anilgarg/Audio-Transmission-and-Reception-over-RF/Transmitter/SourceCode/rfEasyLinkTx_8KSPS_Final_V0/README.md

# rfEasyLinkTx
---

### SysConfig Notice

All examples will soon be supported by SysConfig, a tool that will help you 
graphically configure your software components. A preview is available today in 
the examples/syscfg_preview directory. Starting in 3Q 2019, with SDK version 
3.30, only SysConfig-enabled versions of examples will be provided. For more 
information, click [here](http://www.ti.com/sysconfignotice).

-------------------------

Project Setup using the System Configuration Tool (SysConfig)
-------------------------
The purpose of SysConfig is to provide an easy to use interface for configuring 
drivers, RF stacks, and more. The .syscfg file provided with each example 
project has been configured and tested for that project. Changes to the .syscfg 
file may alter the behavior of the example away from default. Some parameters 
configured in SysConfig may require the use of specific APIs or additional 
modifications in the application source code. More information can be found in 
SysConfig by hovering over a configurable and clicking the question mark (?) 
next to it's name.

### EasyLink Stack Configuration
Many parameters of the EasyLink stack can be configured using SysConfig 
including RX, TX, Radio, and Advanced settings. More information can be found in 
SysConfig by hovering over a configurable and clicking the question mark (?) 
next to it's name. Alternatively, refer to the System Configuration Tool 
(SysConfig) section of the Proprietary RF User's guide found in 
&lt;SDK_INSTALL_DIR&gt;/docs/proprietary-rf/proprietary-rf-users-guide.html. 

Example Summary
---------------
Example includes the EasyLink API and uses it to configure the RF driver to
transmit packets. This project should be run in conjunction with the
rfEasyLinkRx project.

For more information on the EasyLink API and usage refer to the [Proprietary RF User's guide](http://dev.ti.com/tirex/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's%20Guide)

Peripherals Exercised
---------------------
* `Board_PIN_LED1` - Indicates that a packet has been transmitted
* `Board_PIN_LED2` - Indicates an abort which is expected after transmitting 10 packets
 `Board_PIN_LED1` & `Board_PIN_LED2` indicate an error

Resources & Jumper Settings
---------------------------
> If you're using an IDE (such as CCS or IAR), please refer to Board.html in your project
directory for resources used and board-specific jumper settings. Otherwise, you can find
Board.html in the directory &lt;SDK_INSTALL_DIR&gt;/source/ti/boards/&lt;BOARD&gt;.

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

Example Usage
-------------
Run the example. Board_PIN_LED1 will toggle every 100 ms indicating a packet has
been transmitted. This will happen 10 times. The 11th transmission will then be
aborted, toggling Board_PIN_LED2. This cycle will continue.

Before running this application you should first start the rfEasyLinkRx on a
second board to see that the transmitted packets are received.

On the CC1352P-4, if the High PA is enabled, i.e. high output power, the user
may choose to set the output power, using the *EasyLink_setRfPower()*, to 20 dBm
instead of the default 12 dBm.

Application Design Details
--------------------------
This example shows how to use the EasyLink API to access the RF driver, set the
frequency and transmit packets. The RFEASYLINKTX_ASYNC define is used to select
between the Blocking or Async TX API.

The rfEasyLinkTx example will transmit a packet every 10 ms for 10 packets, if
RFEASYLINKTX_ASYNC is defined (as it is by default) then the 11th TX will be
scheduled, but will be aborted. This is to show an example of aborting a TX.
LED2 will toggle when a TX abort happens. Board_PIN_LED1 and Board_PIN_LED2 indicates an
error (not expected to happen). The TX/abort cycle will repeat indefinitely.

A single task, "rfEasyLinkTxFnx", configures the RF driver through the EasyLink
API and transmits messages.

EasyLink API
-------------------------
### Overview
The EasyLink API should be used in application code. The EasyLink API is
intended to abstract the RF Driver in order to give a simple API for
customers to use as is or extend to suit their application[Use Cases]
(@ref USE_CASES).

### General Behavior
Before using the EasyLink API:

  - The EasyLink Layer is initialized by calling EasyLink_init(). This
    initializes and opens the RF driver and configures a modulation scheme
    passed to EasyLink_init.
  - The RX and TX can operate independently of each other.

The following is true for receive operation:

  - RX is enabled by calling EasyLink_receive() or EasyLink_receiveAsync()
  - Entering RX can be immediate or scheduled
  - EasyLink_receive() is blocking and EasyLink_receiveAsync() is non-blocking
  - The EasyLink API does not queue messages so calling another API function
    while in EasyLink_receiveAsync() will return EasyLink_Status_Busy_Error
  - An Async operation can be canceled with EasyLink_abort()

The following apply for transmit operation:

  - TX is enabled by calling EasyLink_transmit(), EasyLink_transmitAsync()
    or EasyLink_transmitCcaAsync()
  - TX can be immediate or scheduled
  - EasyLink_transmit() is blocking and EasyLink_transmitAsync(),
    EasyLink_transmitCcaAsync() are non-blocking
  - EasyLink_transmit() for a scheduled command, or if TX cannot start
  - The EasyLink API does not queue messages so calling another API function
    while in either EasyLink_transmitAsync() or EasyLink_transmitCcaAsync()
    will return EasyLink_Status_Busy_Error
  - An Async operation can be canceled with EasyLink_abort()

### Error Handling
The EasyLink API will return EasyLink_Status containing success or error
  code. The EasyLink_Status codes are:

   - EasyLink_Status_Success
   - EasyLink_Status_Config_Error
   - EasyLink_Status_Param_Error
   - EasyLink_Status_Mem_Error
   - EasyLink_Status_Cmd_Error
   - EasyLink_Status_Tx_Error
   - EasyLink_Status_Rx_Error
   - EasyLink_Status_Rx_Timeout
   - EasyLink_Status_Busy_Error
   - EasyLink_Status_Aborted

### Power Management
The power management framework will try to put the device into the most
power efficient mode whenever possible. Please see the technical reference
manual for further details on each power mode.

The EasyLink Layer uses the power management offered by the RF driver Refer to the RF
Driver documentation for more details.

# No-RTOS Implementation #
The No-RTOS implementation uses *usleep()* to implement the timeout
feature for the asynchronous case.

### Supported Functions
    | Generic API function          | Description                                        |
    |-------------------------------|----------------------------------------------------|
    | EasyLink_init()               | Init's and opens the RF driver and configures the  |
    |                               | specified settings based on EasyLink_Params struct |
    | EasyLink_transmit()           | Blocking Transmit                                  |
    | EasyLink_transmitAsync()      | Non-blocking Transmit                              |
    | EasyLink_transmitCcaAsync()   | Non-blocking Transmit with Clear Channel Assessment|
    | EasyLink_receive()            | Blocking Receive                                   |
    | EasyLink_receiveAsync()       | Non-blocking Receive                                |
    | EasyLink_abort()              | Aborts a non blocking call                         |
    | EasyLink_enableRxAddrFilter() | Enables/Disables RX filtering on the Addr          |
    | EasyLink_getIeeeAddr()        | Gets the IEEE Address                              |
    | EasyLink_setFrequency()       | Sets the frequency                                 |
    | EasyLink_getFrequency()       | Gets the frequency                                 |
    | EasyLink_setRfPower()         | Sets the Tx Power                                  |
    | EasyLink_getRfPower()         | Gets the Tx Power                                  |
    | EasyLink_getRssi()            | Gets the RSSI                                      |
    | EasyLink_getAbsTime()         | Gets the absolute time in RAT ticks                |
    | EasyLink_setCtrl()            | Set RF parameters, test modes or EasyLink options  |
    | EasyLink_getCtrl()            | Get RF parameters or EasyLink options              |
    | EasyLink_getIeeeAddr()        | Gets the IEEE address                              |

### Frame Structure
The EasyLink implements a basic header for transmitting and receiving data. This header supports
addressing for a star or point-to-point network with acknowledgments.

Packet structure:

     _________________________________________________________
    |           |                   |                         |
    | 1B Length | 1-64b Dst Address |         Payload         |
    |___________|___________________|_________________________|

Note for IAR users: When using the CC1310DK, the TI XDS110v3 USB Emulator must
be selected. For the CC1310_LAUNCHXL, select TI XDS110 Emulator. In both cases,
select the cJTAG interface.
