anilgarg/Audio-Transmission-and-Reception-over-RF/Report/backup.pptx

## Adaptive differential pulse code modulation (ADPCM compression technique)

Decoder

Si

+

Mixer

d

Inverse quantization

dq

Mixer

Sp

Quantizer

+

+

Sr

Sp

q

Step size predictor

Adaptive predictor


Encoded code

Sound wave source: [online]http://www.sampleswap.org downloaded:15/10/19

## RF core command handling

RF operation state chart

SDL diagram of the evaluating phase

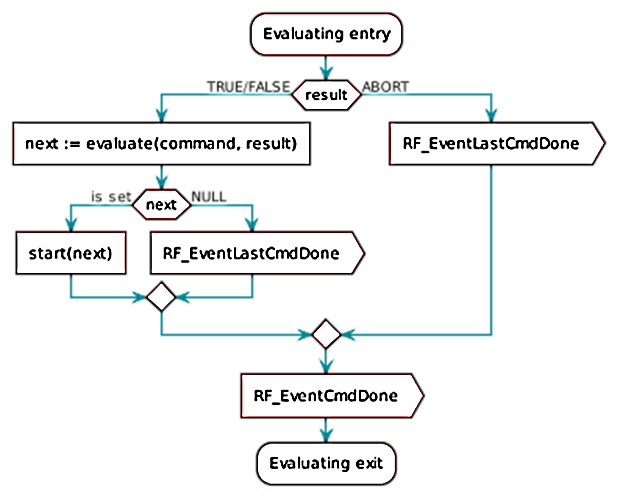
[picture p2: figure]
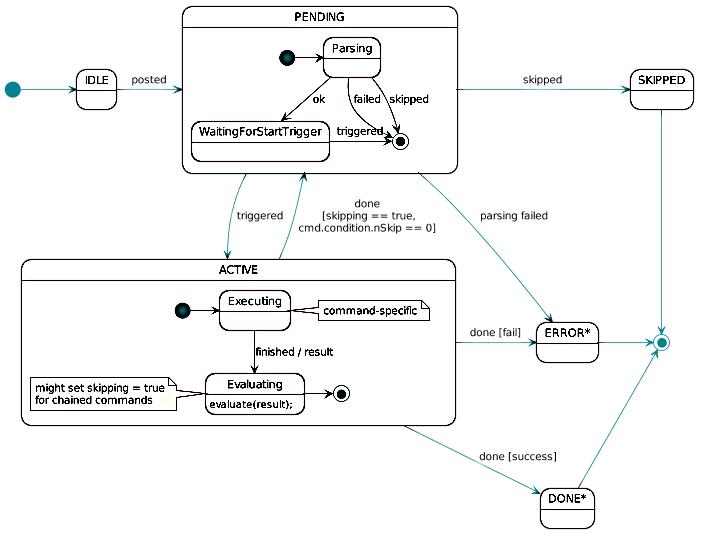
[picture p3: figure]
@startuml scale 0.8 state PENDING { state Parsing state WaitingForStartTrigger [*] -> Parsing Parsing --> WaitingForStartTrigger : ok Parsing --> [*] : failed Parsing --> [*] : skipped WaitingForStartTrigger -> [*] : triggered } state ACTIVE { state Executing note right command-specific end note s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

* Image Source: (https://www.google.co.in/url?cd=&psig=AOvVaw2xpKLntZdZuiC2camuncHq)http://dev.ti.com/tirex/content/simplelink_cc13x0_sdk_1_30_00_06/docs/

## RF core command handling

Callback events for two chained RF operations op1 and op2

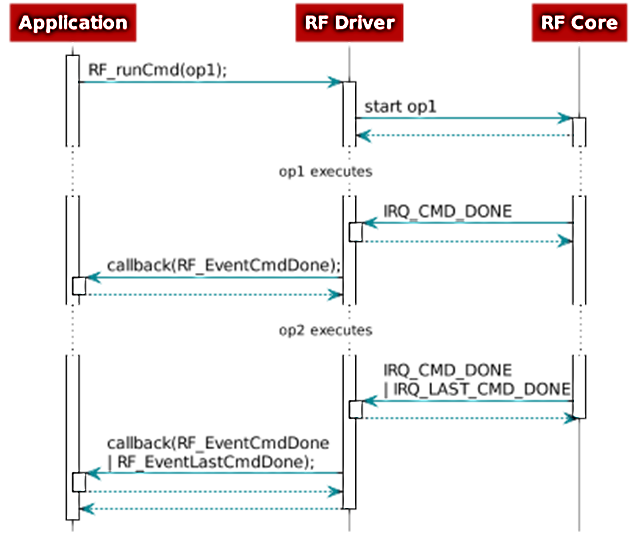
[picture p4: figure]

* Image Source: (https://www.google.co.in/url?cd=&psig=AOvVaw2xpKLntZdZuiC2camuncHq)http://dev.ti.com/tirex/content/simplelink_cc13x0_sdk_1_30_00_06/docs/

Callback events for CMD_PROP_RX

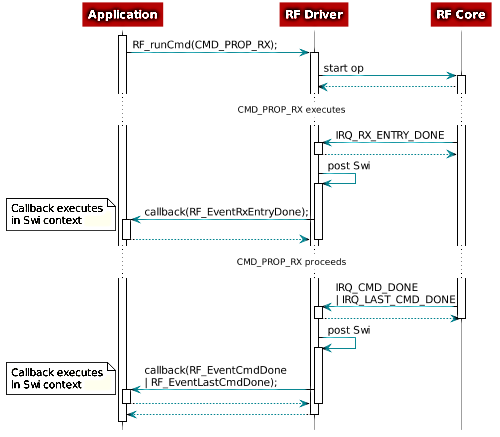
[picture p5: figure]
@startuml scale 0.8 hide footbox participant Application as app participant "RF Driver" as driver participant "RF Core" as rf activate app app -> driver : RF_runCmd(CMD_PROP_RX); activate driver driver -> rf : start op activate rf driver <-- rf ...CMD_PROP_RX executes... driver <- rf : IRQ_RX_ENTR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

## EasyLink API reference

- Data Sending
  - EasyLink layer is initialized by calling EasyLink_init (http://dev.ti.com/tirex/content/simplelink_cc13x0_sdk_2_20_00_38/docs/proprietary-rf/proprietary-rf-users-guide/easylink/easylink-api-reference.html)() (http://dev.ti.com/tirex/content/simplelink_cc13x0_sdk_2_20_00_38/docs/proprietary-rf/proprietary-rf-users-guide/easylink/easylink-api-reference.html).
  - TX is enabled by calling EasyLink_transmitAsync (http://dev.ti.com/tirex/content/simplelink_cc13x0_sdk_2_20_00_38/docs/proprietary-rf/proprietary-rf-users-guide/easylink/easylink-api-reference.html)() (http://dev.ti.com/tirex/content/simplelink_cc13x0_sdk_2_20_00_38/docs/proprietary-rf/proprietary-rf-users-guide/easylink/easylink-api-reference.html)
  - Entering TX can be immediate or scheduled.
  - an Async operation can be cancelled with EasyLink_abort (http://dev.ti.com/tirex/content/simplelink_cc13x0_sdk_2_20_00_38/docs/proprietary-rf/proprietary-rf-users-guide/easylink/easylink-api-reference.html)() (http://dev.ti.com/tirex/content/simplelink_cc13x0_sdk_2_20_00_38/docs/proprietary-rf/proprietary-rf-users-guide/easylink/easylink-api-reference.html)

* Image Source: (https://www.google.co.in/url?cd=&psig=AOvVaw2xpKLntZdZuiC2camuncHq)http://dev.ti.com/tirex/content/simplelink_cc13x0_sdk_1_30_00_06/docs/

Packet Format

- Data Receiving
  - EasyLink layer is initialized by calling EasyLink_init (http://dev.ti.com/tirex/content/simplelink_cc13x0_sdk_2_20_00_38/docs/proprietary-rf/proprietary-rf-users-guide/easylink/easylink-api-reference.html)() (http://dev.ti.com/tirex/content/simplelink_cc13x0_sdk_2_20_00_38/docs/proprietary-rf/proprietary-rf-users-guide/easylink/easylink-api-reference.html).
  - RX is enabled by calling EasyLink_receiveAsync (http://dev.ti.com/tirex/content/simplelink_cc13x0_sdk_2_20_00_38/docs/proprietary-rf/proprietary-rf-users-guide/easylink/easylink-api-reference.html)() (http://dev.ti.com/tirex/content/simplelink_cc13x0_sdk_2_20_00_38/docs/proprietary-rf/proprietary-rf-users-guide/easylink/easylink-api-reference.html).
  - Entering RX can be immediate or scheduled.
  - an Async operation can be cancelled with EasyLink_abort (http://dev.ti.com/tirex/content/simplelink_cc13x0_sdk_2_20_00_38/docs/proprietary-rf/proprietary-rf-users-guide/easylink/easylink-api-reference.html)() (http://dev.ti.com/tirex/content/simplelink_cc13x0_sdk_2_20_00_38/docs/proprietary-rf/proprietary-rf-users-guide/easylink/easylink-api-reference.html)

## Slide 5

Software architecture

Main CPU

1. Main Application
2. Non-RTOS
3. Drivers
4. IDE- Code composer studio

RF core
ARM
Cortex-M0

Sensor controller

Peripherals

Main CPU
ARM
Cortex-M3

RF core

1. Extremely flexible ultra- low power radio
2. Built in autonomous packet engine
3. IDE: Smart RF studio

Sensor controller

1. Ultra low power sensor interface
2. ADC Interface ( 4ksps)

Peripherals

1. GPIO
2. DMA
3. Timer
4. SPI ( DAC Interface)

Software

TI Simple Link PHY
1. 802.15.4g FSK
2. Proprietary
3. Long Range Communication

Power consumption
Main MCU (Active@48Mhz) | 1.2mA + 25.5μA/Hz
Radio Rx | 5.5mA
RF core | 0.237mA
μDMA | 0.130mA
Timer | 0.113mA
I2C | 0.012mA
SPI | 0.093mA
UART | 0.164mA
ADC | 0.750mA
Radio Tx (VDDR=1.95V) , 14dbm o/p power GFSK | 23.5mA
Total | 32.9mA

* Power consumption: CC1310 datasheet

## Problems and solutions

  - Chip select is necessary to latch the DAC output during SPI communication
  - Carrier frequency configuration problem due to incorrect selection command
  - ADC counts calculation problem above 3.3V
  - Synchronization between Tx & RX

## CC1310 Selection

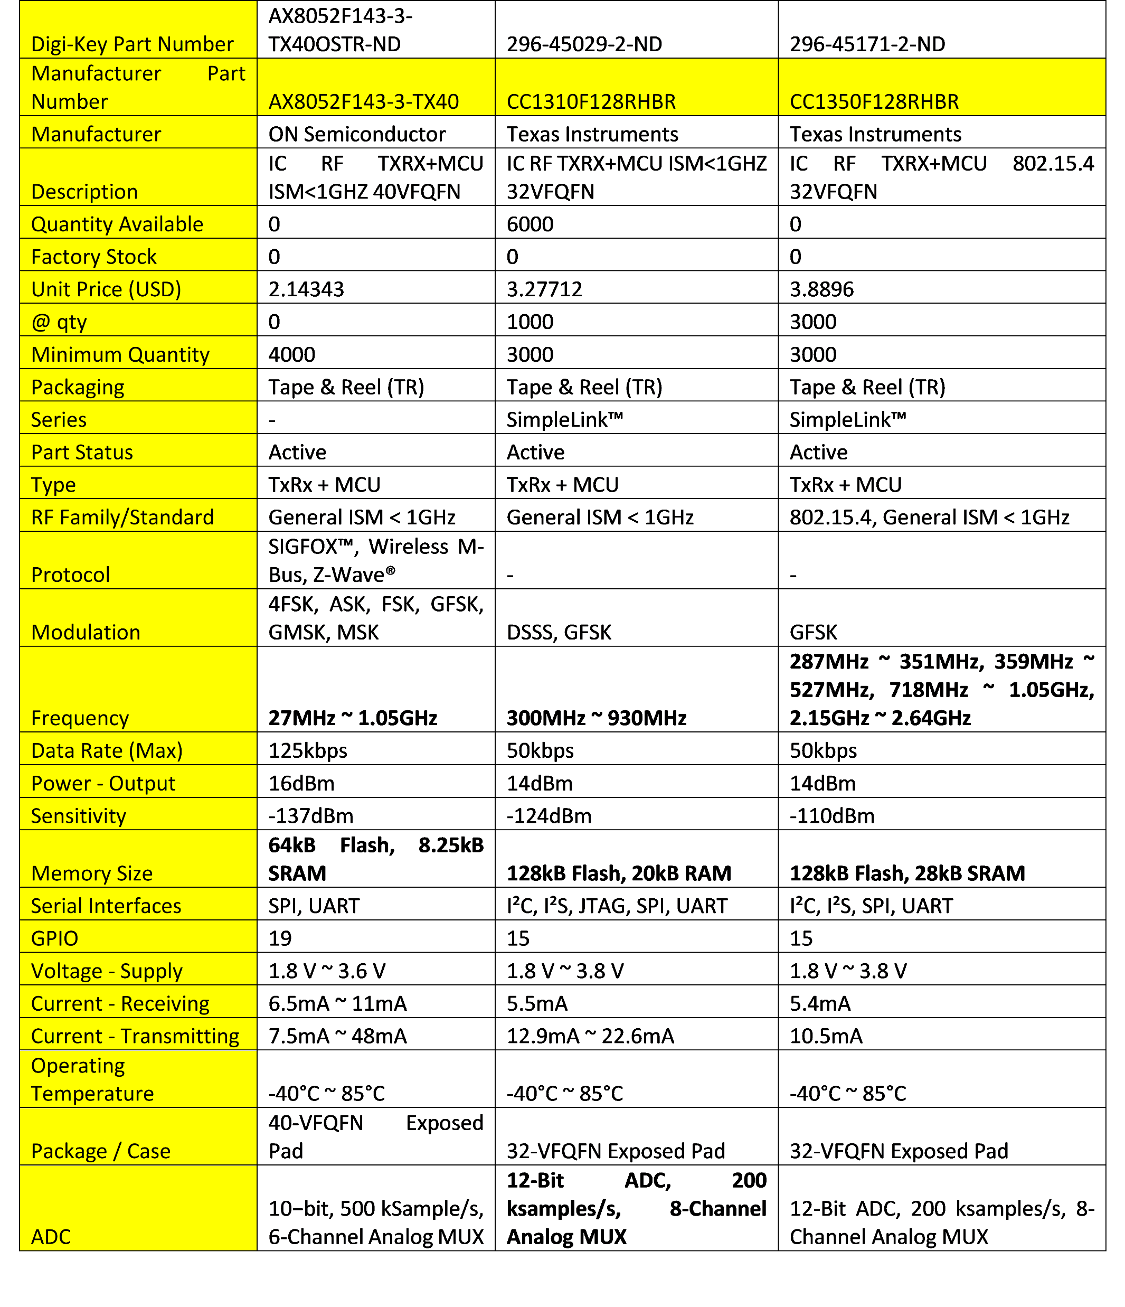
[picture p6: figure]
