anilgarg/Audio-Transmission-and-Reception-over-RF/DesignCalc/MC_Selection.xlsx

Sheet: Sheet1
Datasheets | https://www.onsemi.com/pub/Collateral/AX8052F143-D.PDF | http://www.ti.com/lit/ds/symlink/cc1310.pdf | http://www.ti.com/lit/ds/symlink/cc1350.pdf | 16
Image | //media.digikey.com/Renders/On%20Semi%20Renders/488;485EG;;40.jpg | //media.digikey.com/renders/Texas%20Instr%20Renders/32-QFN-Pkg.jpg | //media.digikey.com/renders/Texas%20Instr%20Renders/32-QFN-Pkg.jpg
Digi-Key Part Number | AX8052F143-3-TX40OSTR-ND | 296-45029-2-ND | 296-45171-2-ND
Manufacturer Part Number | AX8052F143-3-TX40 | CC1310F128RHBR | CC1350F128RHBR
Manufacturer | ON Semiconductor | Texas Instruments | Texas Instruments
Description | IC RF TXRX+MCU ISM<1GHZ 40VFQFN | IC RF TXRX+MCU ISM<1GHZ 32VFQFN | IC RF TXRX+MCU 802.15.4 32VFQFN
Quantity Available | 0 | 6000 | 0
Factory Stock | 0 | 0 | 0
Unit Price (USD) | 2.14343 | 3.27712 | 3.8896
@ qty | 0 | 1000 | 3000
Minimum Quantity | 4000 | 3000 | 3000
Packaging | Tape & Reel (TR) | Tape & Reel (TR) | Tape & Reel (TR)
Series | - | SimpleLink™ | SimpleLink™
Part Status | Active | Active | Active
Type | TxRx + MCU | TxRx + MCU | TxRx + MCU
RF Family/Standard | General ISM < 1GHz | General ISM < 1GHz | 802.15.4, General ISM < 1GHz
Protocol | SIGFOX™, Wireless M-Bus, Z-Wave® | - | -
Modulation | 4FSK, ASK, FSK, GFSK, GMSK, MSK | DSSS, GFSK | GFSK
Frequency | 27MHz ~ 1.05GHz | 300MHz ~ 930MHz | 287MHz ~ 351MHz, 359MHz ~ 527MHz, 718MHz ~ 1.05GHz, 2.15GHz ~ 2.64GHz
Data Rate (Max) | 125kbps | 50kbps | 50kbps
Power - Output | 16dBm | 14dBm | 14dBm
Sensitivity | -137dBm | -124dBm | -110dBm
Memory Size | 64kB Flash, 8.25kB SRAM | 128kB Flash, 20kB RAM | 128kB Flash, 28kB SRAM
Serial Interfaces | SPI, UART | I²C, I²S, JTAG, SPI, UART | I²C, I²S, SPI, UART
GPIO | 19 | 15 | 15
Voltage - Supply | 1.8 V ~ 3.6 V | 1.8 V ~ 3.8 V | 1.8 V ~ 3.8 V
Current - Receiving | 6.5mA ~ 11mA | 5.5mA | 5.4mA
Current - Transmitting | 7.5mA ~ 48mA | 12.9mA ~ 22.6mA | 10.5mA
Operating Temperature | -40°C ~ 85°C | -40°C ~ 85°C | -40°C ~ 85°C
Package / Case | 40-VFQFN Exposed Pad | 32-VFQFN Exposed Pad | 32-VFQFN Exposed Pad
ADC | 10−bit, 500 kSample/s, 6-Channel Analog MUX | 12-Bit ADC, 200 ksamples/s, 8-Channel Analog MUX | 12-Bit ADC, 200 ksamples/s, 8-Channel Analog MUX
Crystal or frequency | 10-50Mhz | 48Mhz

Sheet: CC1310 current
Power Consumption
Main MCU (Active@48Mhz) | 1.2mA + 25.5μA/Hz | 2.424
Radio Tx (VDDR=1.95V) , 14dbm o/p power GFSK | 23.5mA | 23.5 | Active. MCU running CoreMark at 48 MHz: 1.2mA + 25.5 uA/Hz
Radio Rx | 5.5mA | 5.5 | Radio TX, boost mode (VDDR = 1.95 V), 14-dBm output power,
RF core | 0.237mA | 0.237 | (G)FSK, 868 MHz 23.5mA
μDMA | 0.130mA | 0.13 | Radio RX, 868 MHz 5.5 mA
Timer | 0.113mA | 0.113 | RF core 237 uA
I2C | 0.012mA | 0.012 | μDMA 130 uA
SSI | 0.093mA | 0.093 | Timers 113 uA
UART | 0.164mA | 0.164 | I2C 12 uA
ADC | 0.750mA | 0.75 | I2S 36 uA
 |  |  | SSI 93 uA
Total Current@3.3V |  | 32.923 | UART 164 uA
 |  |  |  | RF Core: 237 uA
