anilgarg/Audio-Transmission-and-Reception-over-RF/DesignCalc/Design.xlsx

Sheet: BOM_Transmiter
CC1310 RF : Transmitter module Revised: Thursday, May 21, 2020
Revision:
Bill Of Materials May 21,2020 5:41:48
Item | Quantity | Reference | Part
1 | 1 | A1 | 868MHz/2440MHz Antenna
2 | 1 | CR9 | LS L296-P2Q2-1 RLED
3 | 1 | CR10 | LPL296-J2L2-25 GLED
4 | 7 | C3,C4,C5,C7,C9,C16,C20 | 100nF
5 | 2 | C6,C8 | 22uF
6 | 2 | C11,C22 | 3.6pF
7 | 1 | C12 | 2.7pF
8 | 1 | C13 | 6.2pF
9 | 1 | C14 | 3pF
10 | 2 | C15,C21 | 100pF
11 | 2 | C17,C18 | 12pF
12 | 1 | C19 | 1uF
13 | 1 | C24 | DNM
14 | 1 | C58 | DNM_0402
15 | 2 | C60,C61 | 2.2uF
16 | 1 | C62 | 15pF
17 | 1 | C63 | 680n
18 | 1 | C64 | 2.2u
19 | 1 | C65 | 682p
20 | 1 | FL1 | BLM18HE152SN1 coil | Inductor
21 | 1 | IC1 | LF356 opamp
22 | 1 | L1 | 6.8uH
23 | 2 | L12,L23 | 7.5nH
24 | 2 | L13,L14 | 6.8nH
25 | 1 | L22 | 27nH
26 | 1 | P11 | CONN_HEADER_2X5
27 | 1 | P12 | CONN_HEADER_2X2_P
28 | 1 | P13 | CONN_HEADER_2_P
29 | 2 | R1,R69 | 100k
30 | 1 | R12 | 1.8pF
31 | 1 | R67 | 220
32 | 1 | R68 | 180
33 | 1 | R71 | 6k
34 | 1 | R72 | 51k
35 | 2 | R73,R77 | 30k
36 | 1 | R74 | 68k
37 | 1 | R76 | 75k
38 | 1 | U1 | CC1310F128RGZT
39 | 1 | U12 | TPS79601DR regulator
40 | 1 | U14 | IC_REF_LM4040N_SC70-5 Zener 4.1V
41 | 1 | Y1 | 32.768kHz
42 | 1 | Y2 | 24MHz

Sheet: BOM_Receiver
CC1310 RF eceiver module Revised: Thursday, May 21, 2020
Revision:
Bill Of Materials May 21,2020 5:35:12
Item | Quantity | Reference | Part
1 | 1 | A1 | 868MHz/2440MHz Antenna
2 | 1 | CR9 | LS L296-P2Q2-1 RLED
3 | 1 | CR10 | LPL296-J2L2-25 GLED
4 | 7 | C3,C4,C5,C7,C9,C16,C20 | 100nF
5 | 2 | C6,C8 | 22uF
6 | 2 | C11,C22 | 3.6pF
7 | 1 | C12 | 2.7pF
8 | 1 | C13 | 6.2pF
9 | 1 | C14 | 3pF
10 | 2 | C15,C21 | 100pF
11 | 2 | C17,C18 | 12pF
12 | 1 | C19 | 1uF
13 | 1 | C24 | DNM
14 | 1 | C58 | DNM_0402
15 | 2 | C60,C61 | 2.2uF
16 | 1 | C62 | 15pF
17 | 2 | C66,C67 | 0.1u
18 | 1 | C68 | 40nF
19 | 2 | C69,C72 | 7uF
20 | 2 | C70,C71 | 6.82nF
21 | 1 | FL1 | BLM18HE152SN1 coil | Inductor
22 | 1 | L1 | 6.8uH
23 | 2 | L12,L23 | 7.5nH
24 | 2 | L13,L14 | 6.8nH
25 | 1 | L22 | 27nH
26 | 2 | L24,L25 | 225uH
27 | 1 | P11 | CONN_HEADER_2X5
28 | 1 | P12 | CONN_HEADER_2X2_P
29 | 1 | P13 | 3.5mm audio jack connector
30 | 1 | R1 | 100k
31 | 1 | R12 | 1.8pF
32 | 1 | R67 | 220
33 | 1 | R68 | 180
34 | 1 | R72 | 51k
35 | 1 | R73 | 30k
36 | 1 | R78 | 1k
37 | 2 | R79,R80 | 300k
38 | 1 | U1 | CC1310F128RGZT
39 | 1 | U12 | TPS79601DR regulator
40 | 1 | U15 | MCP4921-EP DAC
41 | 1 | U16 | TPA2005D1 Audio amplifier
42 | 1 | Y1 | 32.768kHz
43 | 1 | Y2 | 24MHz

Sheet: DesignCalc_Analogip_Txmtr
 | AS per reference of tidu765.pdf design
 | For reference microphone Part No: | POM-3535P-R
 |  |  | Selected parameters from microphone datasheet[2]
 |  |  | Parameter | Value (Units)
 |  |  | Sensitivity | -35 +/- 4 dBV
 |  |  | Standard Operating Voltage | 2 Vdc
 |  |  | Current Consumption (Max) | 0.5 mA
 |  |  | Impedance | 2.2 kOhm
 |  |  | Signal to Noise Ratio (Min) | 68 dB
 |  | sensitivity | 17.7827941 | mvolts per Pascal of air pressure
 |  | The output current per Pascal of air pressure
 |  |  | 8.083088227 | μA/Pa
 | Imic | microphone output current for 2Pa Air pressure
 |  |  | 16.16617645 | μA
 |  | V(volt) | 1.228 | (considering)
 |  | R76 = V/Imic
 |  | R76 | 75 | kOhm
 |  | C65 | use for compansates for parasitic capacitance at the op amp inverting input which can cause instability. Capacitor C2 also forms a pole with resistor R2 in the response of the pre-amplifier. The frequency of this pole must be high enough to not affect the microphone transfer function within the audible bandwidth. For this design, a response deviation of -0.1dB at 500Hz is acceptable.
 |  | The location of the pole can be calculated using the relative gain at 500Hz
 |  | fp | 3343.124589 | Hz
 |  | C65 | 1/(2*PI*fp*R76)
 |  | C65 | 6.347552571e-07 | nF | 682 | pF
 | Microphone Bias Resistor and Coupling Capacitor
 | R71 | (Vcc - Vmic)/Is
 | R71 | 6 | kOhm
 | For HPF : cuttoff freq | fc | 50 | Hz
 | C63 | 1/(2*PI*R71*fc) | 0.000530516477 | 530.516477 | 680 | nF
 | VDD | 5 | V
 | R69 | 100 | k
 | R74 | 68 | k
 | Vref ( at +terminal on opamp) | 2.023809524 | V
 | iD | 0.02976190476 | 29.76190476 | uA
 | C64 | use to filter thermal noise created by the resister |  | 2.2 | uF
 | fc | 1.7873015 | Hz
 | Noise gain | 13.5
Simulation results

Sheet: DesignCalc_Analogop_Rxver
 |  |  |  |  |  | ref by datasheet
 | Gain | 1
 | R79 | 300 | k
 | R80 | 300 | k |  | Application Schematic With TPA2005D1 Summing Two Single-Ended Inputs
 | fc1 | 150 | Hz | considering
 | C70 | 3.536776513e-09 | F
 |  | 3.536776513 | nF |  | TPA2005D1 1.4-W MONO Filter-Free Class-D Audio Power Amplifier
 | C71 | 3.536776513 | nF
 | RBTL | 4 | ohm | considering
 | f | 4000 | hz BW
L25 | L24 | 225.079079 | uH
C72 | C69 | 7.03372122 | uF
 |  |  |  |  | OP of Class D amplifier
 |  |  |  |  | Type-2 Filter Equivalent Circuit
 |  |  |  |  | as per reference: SLAA701A–October 2016–Revised November 2016
 |  |  |  |  | RL = RBTL

Sheet: Design_calc_RF
ADC samplin Rate |  | 8000 | SPS |  |  | RF field
Buffer size |  | 100
ENOB |  | 12 | bits |  |  | symbol rate | 50 | kbps
ADPCM compression |  | 12-04 bits |  |  |  | Modulation | 2GFSK
Time for sampling |  | 0.0125 | sec |  |  | Deviation | 25 | kHz
ADC callback time |  | 0.0125 | sec |  |  | frequency | 868 | Mhz
 |  |  |  |  |  | Rx Filter BW | 98 | kHz
Tranmiting bit rate |  | 50 | kbps |  |  | Tx Power | 14 | dbm
frame overhead |  | 10 | bytes
data |  | 52 | bytes
Sequence number |  | 2 | bytes
header |  | 2 | bytes
CRC |  | 2 | bytes
Frame structure
 |  |  | header |  |  | Data field
 | Preamble | Sync word | length | adress size | sequence number size | data (code) | ADPCM init value | CRC
 | 4 byte | 4 byte | 1 byte | 1 byte | 2 byte | 52 byte | 2 bye | 2 byte
Total frame size |  | 68
Total command time |  | 10.88 | msec
ADC Sampling time |  | 12.5 | msec
Time remaining for ADPCM |  | 1.62 | msec

Sheet: Power Budget
For CC1310
Power consumption |  | TX(current) | Rx (current) | Tx(mVA) | Rx (mVA)
Main MCU (Active@48Mhz) | 1.2mA + 25.5μA/Hz | 2.424 | 2.424 | 7.9992 | 7.9992
Radio Rx | 5.5mA |  | 5.5 | 0 | 10.725
RF core | 0.237mA | 0.237 | 0.237 | 0.46215 | 0.46215
μDMA | 0.130mA | 0.13 | 0.13 | 0.429 | 0.429
Timer | 0.113mA | 0.113 | 0.113 | 0.3729 | 0.3729
I2C | 0.012mA |  |  | 0 | 0
SPI | 0.093mA |  | 0.093 | 0 | 0.3069
UART | 0.164mA | 0.164 | 0.164 | 0.5412 | 0.5412
ADC | 0.750mA | 0.75 |  | 2.475 | 0
Radio Tx (VDDR=1.95V) , 14dbm o/p power GFSK | 23.5mA | 23.5 |  | 45.825 | 0
Total | 32.9mA | 27.318 | 8.661 | 58.10445 | 20.83635
 | TPS796 | 0.265 | mamp
Transmitter
 | Analog signal conditioning
 | CC1310 | 32.9mA |  |  | Analog signal conditinging
 |  |  |  |  |  | opamp | 5mA | at 15V | LF356
Receiver | CC1310 |  |  |  |  | resistence devider | 0.02976190476 | mA | at 5V
 | MCP4921 | 0.35 | mA | at 5V |  | opamp | 2mA | 15V | LF155
 | Audio amplifier TPA2005D1 | 3.5 | mA | at 5V
 | LED1 220 ohm | 15 |  | at 3.3V
 | LED2 180ohm | 18.33333333 |  | at 3.3V
Transmitter current
 | VA (mW)
CC1310 Circuit | 58.10445
Opamp LF356 | 75
resister devider | 0.1488095238
Power regulator | 1.325
LED GREEN | 49.5
LED RED | 60.5
Total current | 244.5782595
Current@5V | 48.9156519
Receiver current
 | VA (mW)
CC1310 Circuit | 10.725
MCP4921 | 1.75
Audio amplifier TPA2005D1 | 17.5
Power regulator | 1.325
LED GREEN | 49.5
LED RED | 60.5
Total current | 141.3
Current@5V | 28.26

Sheet: Costing
CC1310 RF : Transmitter module Revised: Thursday, May 21, 2020
Revision:
Bill Of Materials May 21,2020 5:41:48 |  |  |  |  |  |  | $ | 75.51
Item | Quantity | Reference | Part |  | cost(PU) | Total | Rs
1 | 1 | A1 | 868MHz/2440MHz | Antenna | NA
2 | 1 | CR9 | LS L296-P2Q2-1 | RLED | 0.11821 | 0.11821 | 8.9260371
3 | 1 | CR10 | LPL296-J2L2-25 | GLED | 0.11821 | 0.11821 | 8.9260371
4 | 1 | FL1 | BLM18HE152SN1 | Inductor | 0.06619 | 0.06619 | 4.9980069
5 | 1 | IC1 | LF356 | opamp | 0.297 | 0.297 | 22.42647
9 | 1 | U1 | CC1310F128RGZT |  | 4.8564 | 4.8564 | 366.706764
10 | 1 | U12 | TPS79601DR | regulator | 2.3403 | 2.3403 | 176.716053
11 | 1 | U14 | IC_REF_LM4040N_SC70-5 | Zener 4.1V | 0.5292 | 0.5292 | 39.959892
12 | 1 | Y1 | 32.768kHz |  | 0.77 | 0.77 | 58.1427
13 | 1 | Y2 | 24MHz |  | 0.77 | 0.77 | 58.1427
14 | 27 | caps |  |  | 0.00153 | 0.04131 | 3.1193181
15 | 11 | Res |  |  | 0.00134 | 0.01474 | 1.1130174
16 | 6 | Inductor |  |  | 0.0777 | 0.4662 | 35.202762
 |  |  |  | Total |  | 10.38776 | 784.3797576
CC1310 RF eceiver module Revised: Thursday, May 21, 2020
Revision:
Bill Of Materials May 21,2020 5:35:12
Item | Quantity | Reference | Part |  | cost(PU) | Total
1 | 1 | A1 | 868MHz/2440MHz |  | NA |  |  |  | `
2 | 1 | CR9 | LS L296-P2Q2-1 | RLED | 0.11821 | 0.11821 | 8.9260371
3 | 1 | CR10 | LPL296-J2L2-25 | GLED | 0.11821 | 0.11821 | 8.9260371
4 | 1 | FL1 | BLM18HE152SN1 | Inductor | 0.06619 | 0.06619 | 4.9980069
7 | 1 | P13 | 3.5mm audio jack connector |  | 0.4832 | 0.4832 | 36.486432
8 | 1 | U1 | CC1310F128RGZT |  | 4.8564 | 4.8564 | 366.706764
9 | 1 | U12 | TPS79601DR | regulator | 2.3403 | 2.3403 | 176.716053
10 | 1 | U15 | MCP4921-EP | DAC | 1.49 | 1.49 | 112.5099
11 | 1 | U16 | TPA2005D1 | Audio amplifier | 0.35 | 0.35 | 26.4285
12 | 1 | Y1 | 32.768kHz |  | 0.77 | 0.77 | 58.1427
13 | 1 | Y2 | 24MHz |  | 0.77 | 0.77 | 58.1427
14 | 31 | caps |  |  | 0.00153 | 0.04743 | 3.5814393
15 | 8 | ind |  |  | 0.0777 | 0.6216 | 46.937016
16 | 9 | res |  |  | 0.00134 | 0.01206 | 0.9106506
 |  |  |  | Total |  | 12.0436 | 909.412236
