anilgarg/Audio-Transmission-and-Reception-over-RF/(list of files, cad)

Other CAD files:
Receiver/SourceCode/rfEasyLinkRx_868MHz_Final_V0/Debug/easylink/easylink_config.obj
Receiver/SourceCode/rfEasyLinkRx_868MHz_Final_V0/Debug/smartrf_settings/smartrf_settings.obj
Transmitter/SourceCode/rfEasyLinkTx_8KSPS_Final_V0/Debug/easylink/easylink_config.obj
Transmitter/SourceCode/rfEasyLinkTx_8KSPS_Final_V0/Debug/smartrf_settings/smartrf_settings.obj
Receiver/SourceCode/rfEasyLinkRx_868MHz_Final_V0/Debug/easylink/EasyLink_nortos.obj
Receiver/SourceCode/rfEasyLinkRx_868MHz_Final_V0/Debug/smartrf_settings/smartrf_settings_predefined.obj
Transmitter/SourceCode/rfEasyLinkTx_8KSPS_Final_V0/Debug/easylink/EasyLink_nortos.obj
Transmitter/SourceCode/rfEasyLinkTx_8KSPS_Final_V0/Debug/smartrf_settings/smartrf_settings_predefined.obj
