anilgarg/Audio-Transmission-and-Reception-over-RF/Receiver/schematic/WithCompander/CC1310_Receiver_sch_withcompandor.pdf

CC1310_VDD VDDS BLM18HE152SN1 | VDDS Decoupling Capacitors Pin 44Pin 22 C3 C4 C5 C6 | Receiver module L1 DCDC_SW 1 2 C7 Place L1 and C8 close to pin 33 | VDDR VDDR Decoupling Capacitors C16

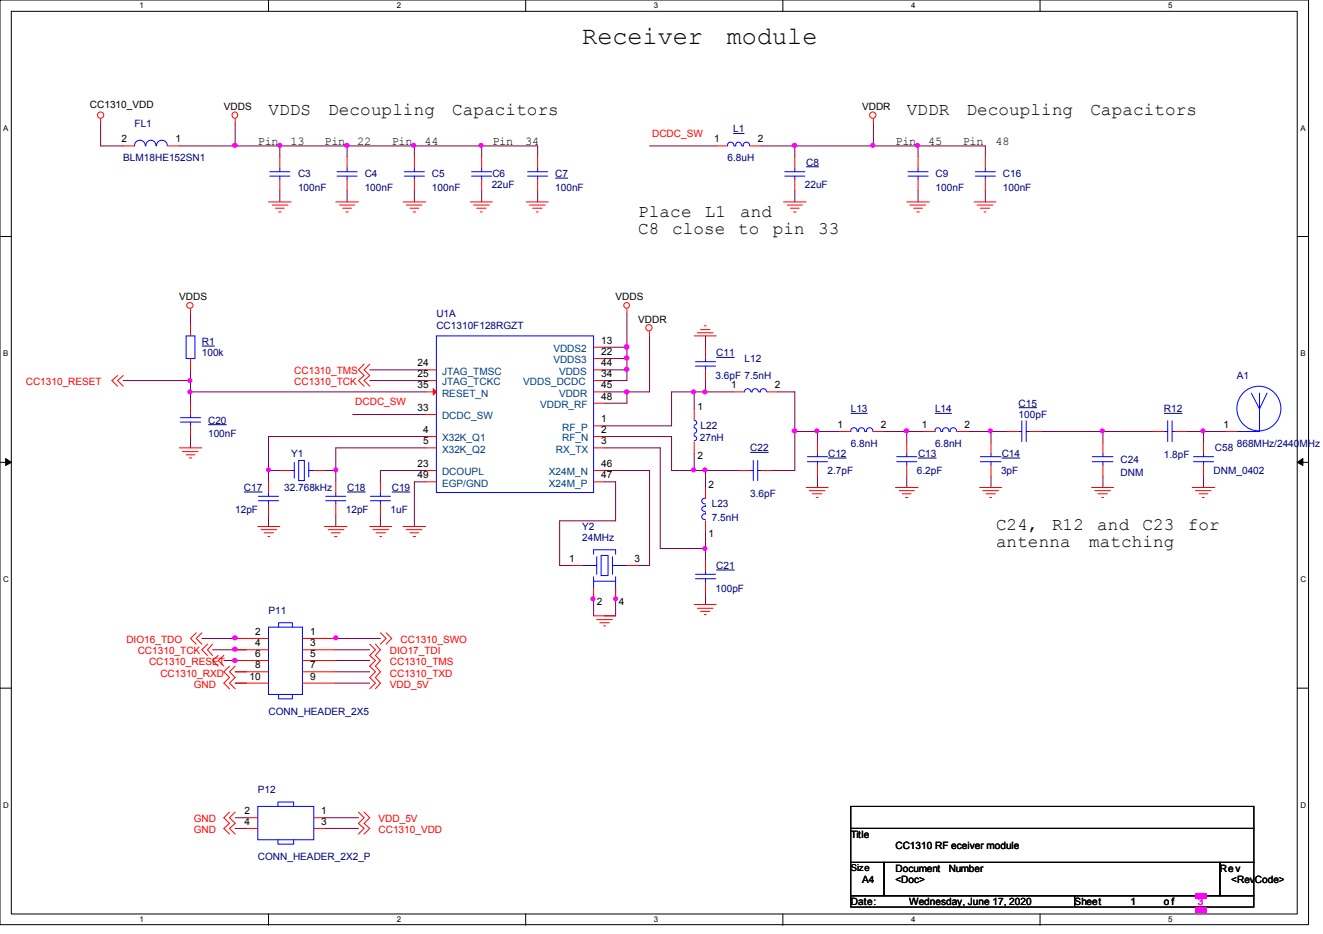
[picture p7: page 1]

B | VDDS R1 100k C20 | U1A CC1310F128RGZT 24 CC1310_TMS JTAG_TMSC 25 35 JTAG_TCKC RESET_N DCDC_SW 33 DCDC_SW 4 5 X32K_Q1 | VDDS | A1 | B

## Power Supply 5V to 3.3VDC

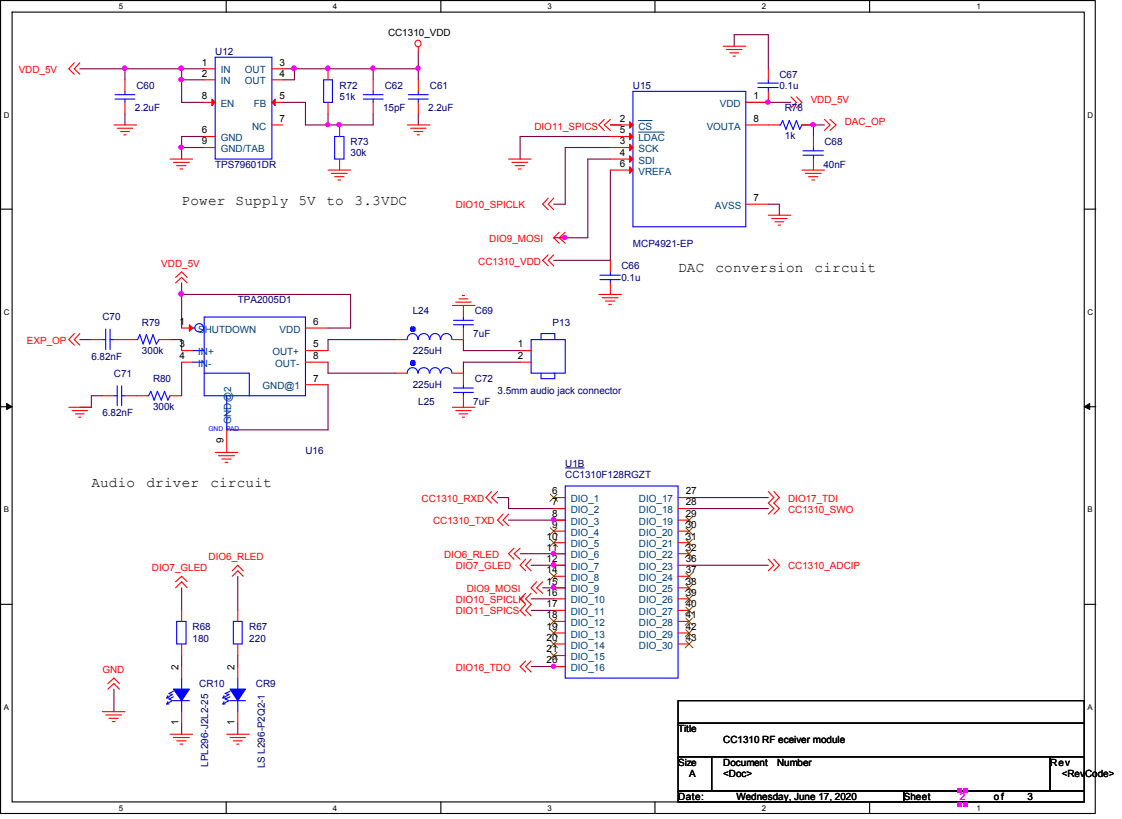
[picture p8: page 2]

CS LDAC SCK SDI VREFA | VDD VOUTA AVSS

C | VDD_5V | P13 2 3.5mm audio jack connector | 0.1u | DAC conversion circuit | C

TPA2005D1

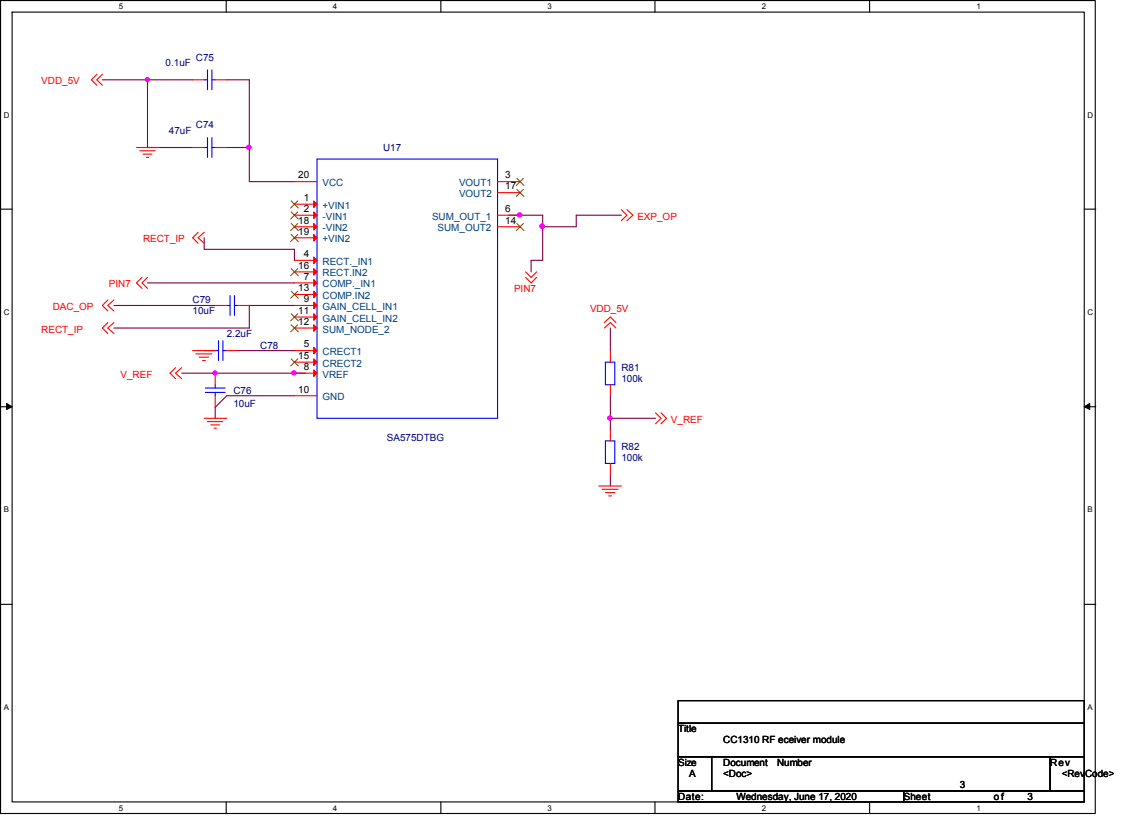
[picture p9: page 3]

VCC +VIN1 | VOUT1 VOUT2

C | PIN7 DAC_OP RECT_IP | -VIN1 SUM_OUT_1 -VIN2 SUM_OUT2 +VIN2 RECT._IN1 RECT.IN2 COMP._IN1 COMP.IN2 GAIN_CELL_IN1 GAIN_CELL_IN2 SUM_NODE_2 CRECT1 CRECT2 VREF GND | VDD_5V R81 100k | | | C

B | | | | V_REF | | B

Title Title Title CC1310 RF eceiver module CC1310 RF eceiver module CC1310 RF eceiver module Size Size Size Document Number Document Number Document Number A A A | Rev Rev Rev 3Wednesday, June 17, 2020 3Wednesday, June 17, 2020 3Wednesday, June 17, 2020
