anilgarg/Audio-Transmission-and-Reception-over-RF/Transmitter/schematic/WithCompander/CC1310_Transmitter_sch_withcompander.pdf

CC1310_VDD VDDS BLM18HE152SN1 | CC1310 RF : Transmitter module VDDS Decoupling Capacitors Pin 44Pin 22 C3 C4 C5 C6 | L1 DCDC_SW 1 2 C7 Place L1 and C8 close to pin 33 | VDDR VDDR Decoupling Capacitors C16

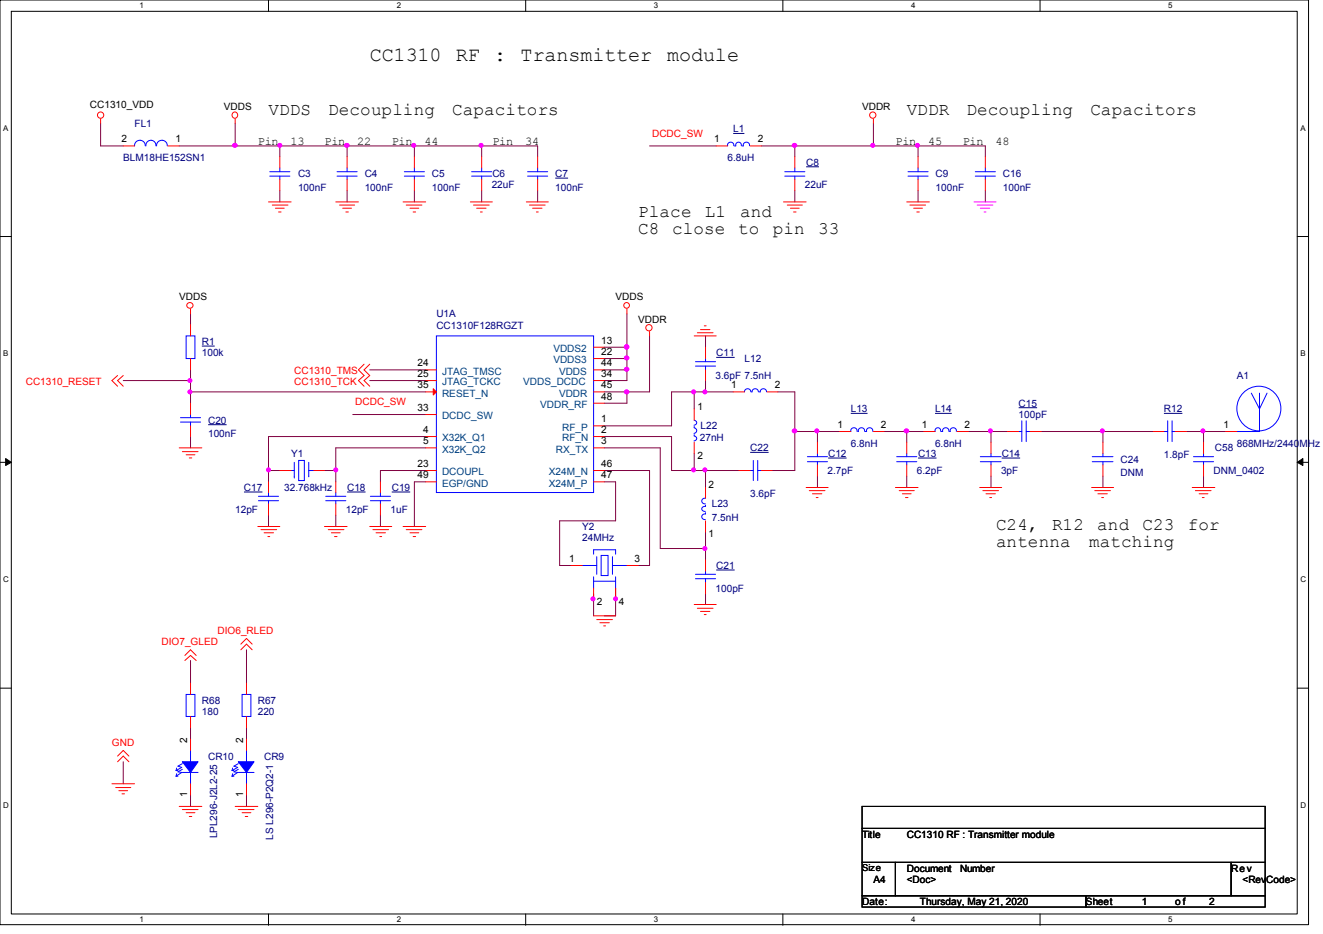
[picture p10: page 1]

B | VDDS R1 100k | U1A CC1310F128RGZT 24 CC1310_TMS JTAG_TMSC 25 35 JTAG_TCKC RESET_N DCDC_SW 33 DCDC_SW 4 5 X32K_Q1 | VDDS | A1 | B

C | C17 12pF DIO6_RLED DIO7_GLED | | | C24, antenna matching | R12 and C23 for | C

R68 180 | R67 220 | | | Title Title Title CC1310 RF : Transmitter module CC1310 RF : Transmitter module CC1310 RF : Transmitter module Size Size Size Document Number Document Number Document Number A4 A4 A4 <Doc> Date: | Re v Re v Re v <RevCode> Sheet 1 1 1 o f 2Thursday, May 21, 2020 2Thursday, May 21, 2020 2Thursday, May 21, 2020

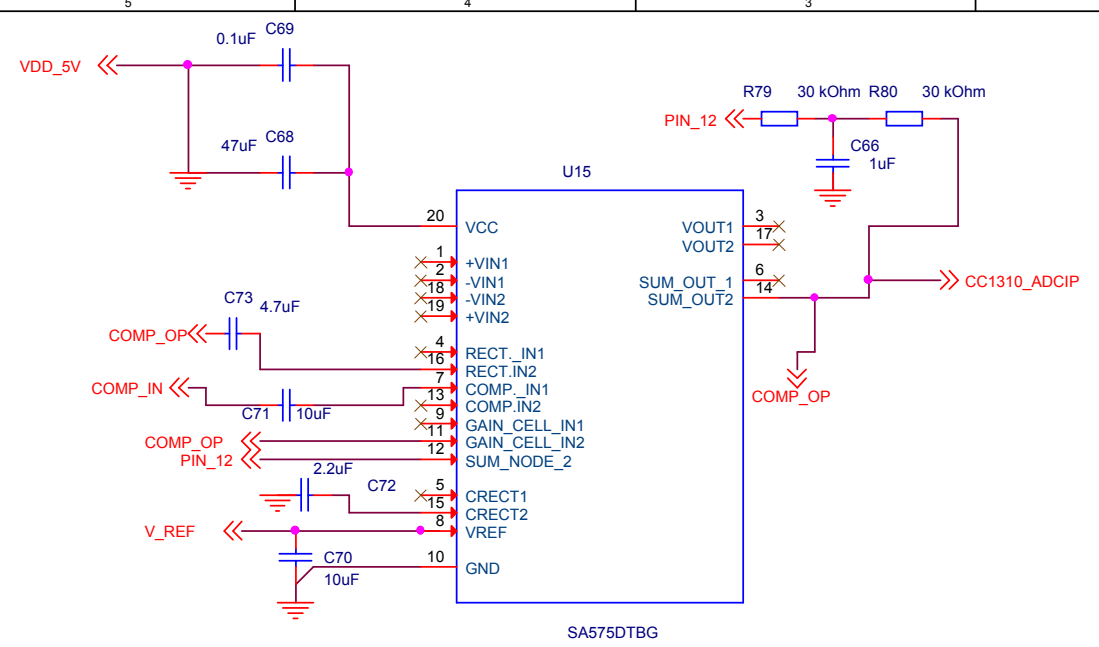
[picture p11: page 2]

VCC +VIN1 -VIN1 -VIN2 +VIN2 | VOUT1 VOUT2 SUM_OUT_1 SUM_OUT2

C | COMP_OP V_REF | 4 16 | RECT._IN1 RECT.IN2 COMP._IN1 COMP.IN2 GAIN_CELL_IN1 GAIN_CELL_IN2 SUM_NODE_2 CRECT1 CRECT2 VREF GND | C

Title Title Title CC1310 RF : Transmitter module CC1310 RF : Transmitter module CC1310 RF : Transmitter module Size Size Size Document Number Document Number Document Number A A A | Rev Rev Rev 1 1 1 1Wednesday, June 17, 2020 1Wednesday, June 17, 2020 1Wednesday, June 17, 2020

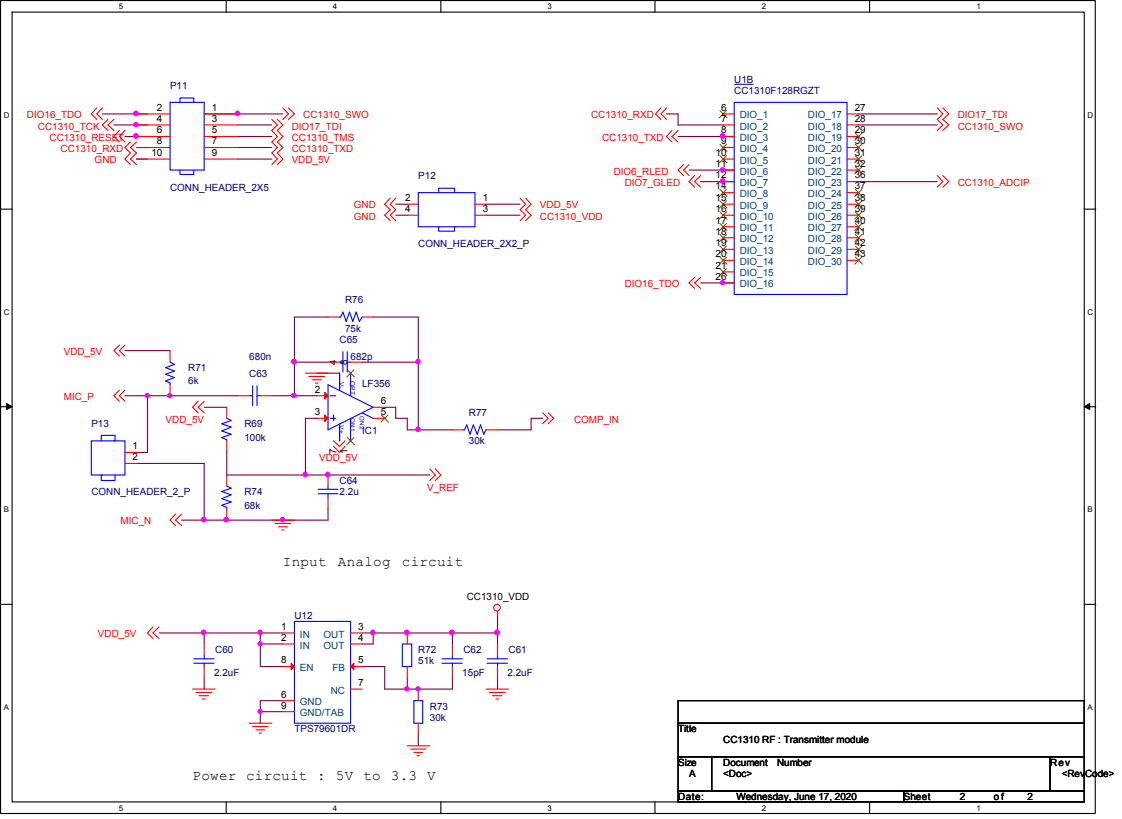
[picture p12: page 3]
