anilgarg/Audio-Transmission-and-Reception-over-RF/Transmitter/schematic/WithoutCompander/CC1310_Transmitter_sch_V0.pdf

CC1310_VDD VDDS BLM18HE152SN1 | CC1310 RF : Transmitter module VDDS Decoupling Capacitors Pin 44Pin 22 C3 C4 C5 C6 | L1 DCDC_SW 1 2 C7 Place L1 and C8 close to pin 33 | VDDR VDDR Decoupling Capacitors C16

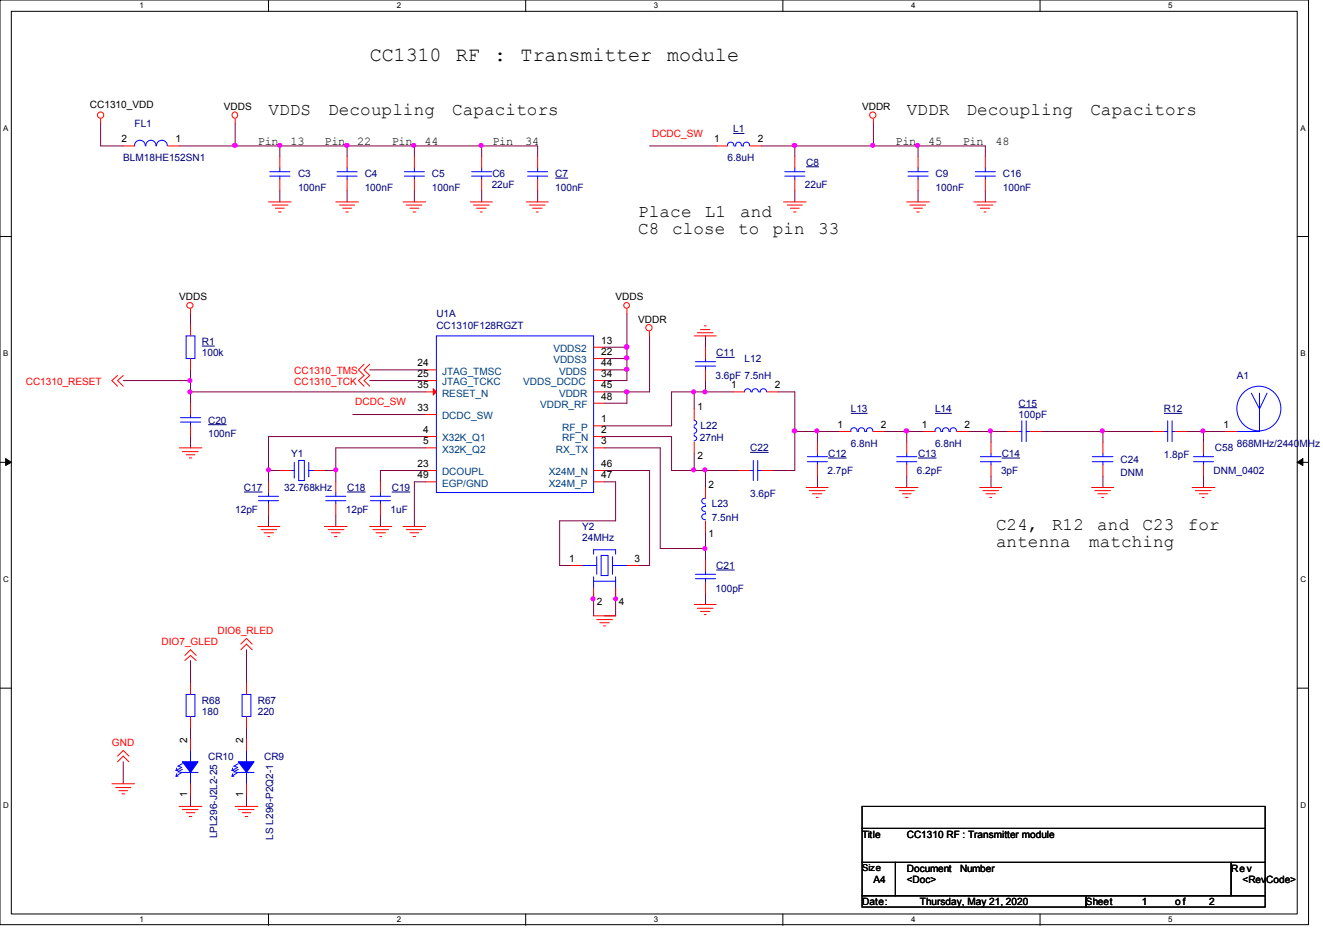
[picture p15: page 1]

B | VDDS R1 100k | U1A CC1310F128RGZT 24 CC1310_TMS JTAG_TMSC 25 35 JTAG_TCKC RESET_N DCDC_SW 33 DCDC_SW 4 5 X32K_Q1 | VDDS | | A1 | B

C | C17 12pF DIO6_RLED DIO7_GLED | | | C24, antenna matching | R12 and C23 for | C

R68 180 | R67 220 | | | Title Title Title CC1310 RF : Transmitter module CC1310 RF : Transmitter module CC1310 RF : Transmitter module Size Size Size Document Number Document Number Document Number A4 A4 A4 <Doc> <Doc> <Doc> Date: Date: Date: | Re v Re v Re v <RevCode> <RevCode> <RevCode> Sheet Sheet Sheet 1 1 1 o f o f o f 2Thursday, May 21, 2020 2Thursday, May 21, 2020 2Thursday, May 21, 2020

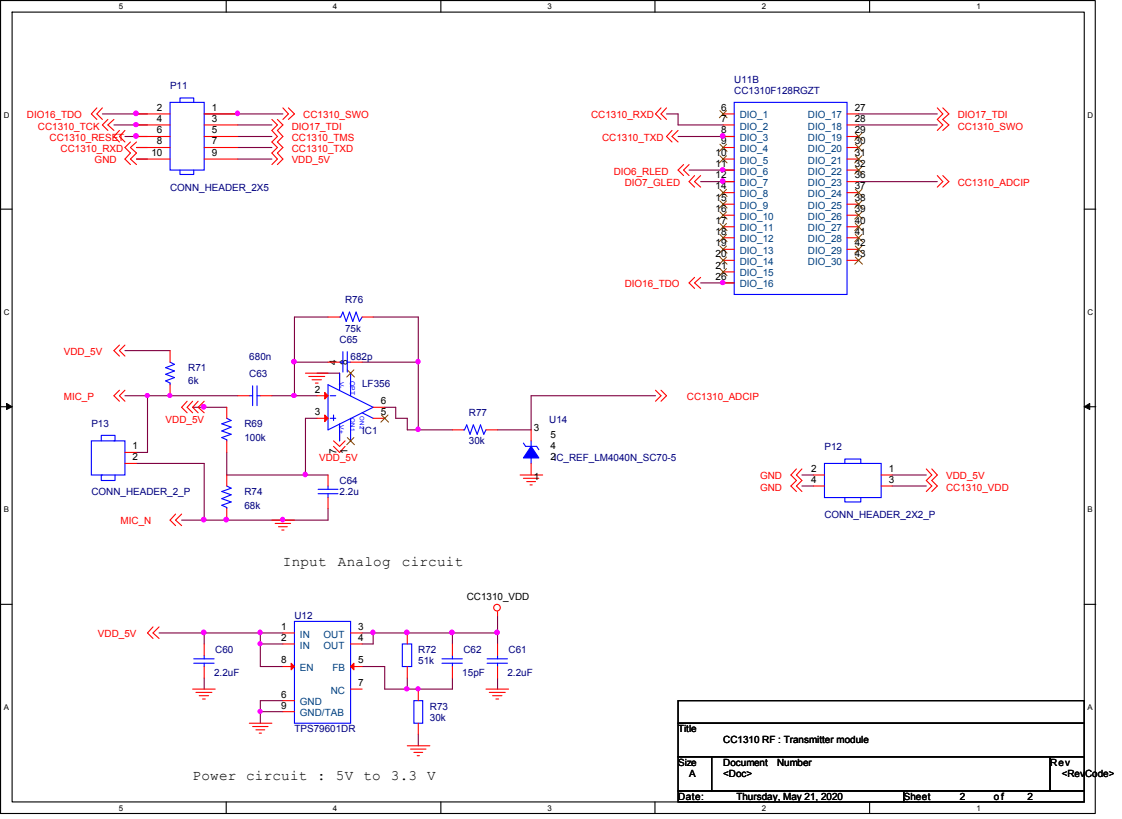
[picture p16: page 2]

P11 2 1 DIO16_TDO 4 3 CC1310_TCK 6 5 CC1310_RESET 8 7 CC1310_RXD 10 9 GND CONN_HEADER_2X5 | CC1310_SWO DIO17_TDI CC1310_TMS CC1310_TXD VDD_5V | CC1310_RXD CC1310_TXD DIO6_RLED DIO7_GLED | U11B CC1310F128RGZT 6 27 8 29 DIO_3 DIO_19 9 30 DIO_4 DIO_20 10 31 DIO_5 DIO_21 11 32 DIO_6 DIO_22 12 36 DIO_7 DIO_23 14 37 DIO_8 DIO_24 15 38 DIO_9 DIO_25 | DIO17_TDI CC1310_SWO CC1310_ADCIP

C | R71 6k | R76 | DIO16_TDO | DIO_10 DIO_26 17 40 DIO_11 DIO_27 18 41 19 DIO_12 DIO_28 42 DIO_13 DIO_29 20 43 DIO_14 DIO_30 21 DIO_15 26 DIO_16 CC1310_ADCIP | C
