anilgarg/Audio-Transmission-and-Reception-over-RF/(list of files, drawings)

Other design files:
Receiver/schematic/WithCompander/Cadence/LAUNCHXL-CC1310.DSN
Receiver/schematic/WithCompander/Cadence/launchxl-cc1310.opj
Transmitter/schematic/WithCompander/Cadence/LAUNCHXL-CC1310.DSN
Transmitter/schematic/WithCompander/Cadence/launchxl-cc1310.opj
