anilgarg/Audio-Transmission-and-Reception-over-RF/Transmitter/SourceCode/rfEasyLinkTx_8KSPS_Final_V0/test_samples.c

/*
 * test_samples.c
 *
 *  Created on: 03-May-2020
 *      Author: anilh
 */

#include <stdint.h>

int16_t Testsamplebuffer[] =
 {
 718 ,
 844 ,
 978 ,
 1118    ,
 1264    ,
 1415    ,
 1570    ,
 1728    ,
 1887    ,
 2048    ,
 2209    ,
 2368    ,
 2526    ,
 2681    ,
 2832    ,
 2978    ,
 3118    ,
 3252    ,
 3378    ,
 3496    ,
 3605    ,
 3705    ,
 3794    ,
 3873    ,
 3940    ,
 3996    ,
 4039    ,
 4071    ,
 4090    ,
 4096    ,
 4090    ,
 4071    ,
 4039    ,
 3996    ,
 3940    ,
 3873    ,
 3794    ,
 3705    ,
 3605    ,
 3496    ,
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
 };

int16_t Testsamplebuffer2[] =
 {
1311    ,
1549    ,
1788    ,
2020    ,
2199    ,
2282    ,
2306    ,
2266    ,
2097    ,
1859    ,
1608    ,
1364    ,
1146    ,
1018    ,
973 ,
1014    ,
1153    ,
1346    ,
1609    ,
1834    ,
2051    ,
2208    ,
2297    ,
2294    ,
2198    ,
1997    ,
1783    ,
1525    ,
1284    ,
1099    ,
987 ,
952 ,
1026    ,
1162    ,
1387    ,
1628    ,
1865    ,
2080    ,
2233    ,
2299    ,
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
};

unsigned char samplebuffer[] = {
                               168 ,
                               165 ,
                               162 ,
                               159 ,
                               156 ,
                               153 ,
                               149 ,
                               146 ,
                               143 ,
                               140 ,
                               137 ,
                               133 ,
                               130 ,
                               127 ,
                               123 ,
                               120 ,
                               117 ,
                               114 ,
                               110 ,
                               107 ,
                               104 ,
                               100 ,
                               97  ,
                               94  ,
                               91  ,
                               88  ,
                               85  ,
                               82  ,
                               80  ,
                               77  ,
                               74  ,
                               72  ,
                               69  ,
                               67  ,
                               64  ,
                               62  ,
                               60  ,
                               57  ,
                               56  ,
                               54  ,
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
