anilgarg/Audio-Transmission-and-Reception-over-RF/Receiver/SourceCode/rfEasyLinkRx_868MHz_Final_V0/samples.c

/*
 * samples.c
 *
 *  Created on: 06-Sep-2019
 *      Author: anilh
 */




unsigned short TxBufferToDAC[100];
/*= {
                                  453    ,
                                  1454    ,
                                  2585    ,
                                  3190    ,
                                  2908    ,
                                  1859    ,
                                  724 ,
                                  172 ,
                                  486 ,
                                  1501    ,
                                  2620    ,
                                  3194    ,
                                  2849    ,
                                  1798    ,
                                  670 ,
                                  165 ,
                                  516 ,
                                  1553    ,
                                  2665    ,
                                  3199    ,
                                  2821    ,
                                  1755    ,
                                  644 ,
                                  163 ,
                                  546 ,
                                  1596    ,
                                  2697    ,
                                  3197    ,
                                  2784    ,
                                  1693    ,
                                  608 ,
                                  162 ,
                                  596 ,
                                  1655    ,
                                  2741    ,
                                  3200    ,
                                  2742    ,
                                  1653    ,
                                  568 ,
                                  165 ,
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



};
*/
