anilgarg/Audio-Transmission-and-Reception-over-RF/(commit log)

2020-06-17 Compander circuit added
    [BOM_Transmitter.xls, LAUNCHXL-CC1310.DSN, LAUNCHXL-CC1310.brd, RECEIVER_BOM.xls, art_param.txt, cases.cfg, launchxl-cc1310.opj, nc_param.txt]
2020-06-17 CC1310 selection
    [MC_Selection.xlsx]
2020-06-26 updated mtp report and receiver code added filter
    [EasyLink_nortos.obj, easylink_config.obj, smartrf_settings.obj, smartrf_settings_predefined.obj]
2020-07-04 Modifications after review
    [Design.xlsx]
